tjko/ucs-millennium-falcon-led-controller/schematic.pdf

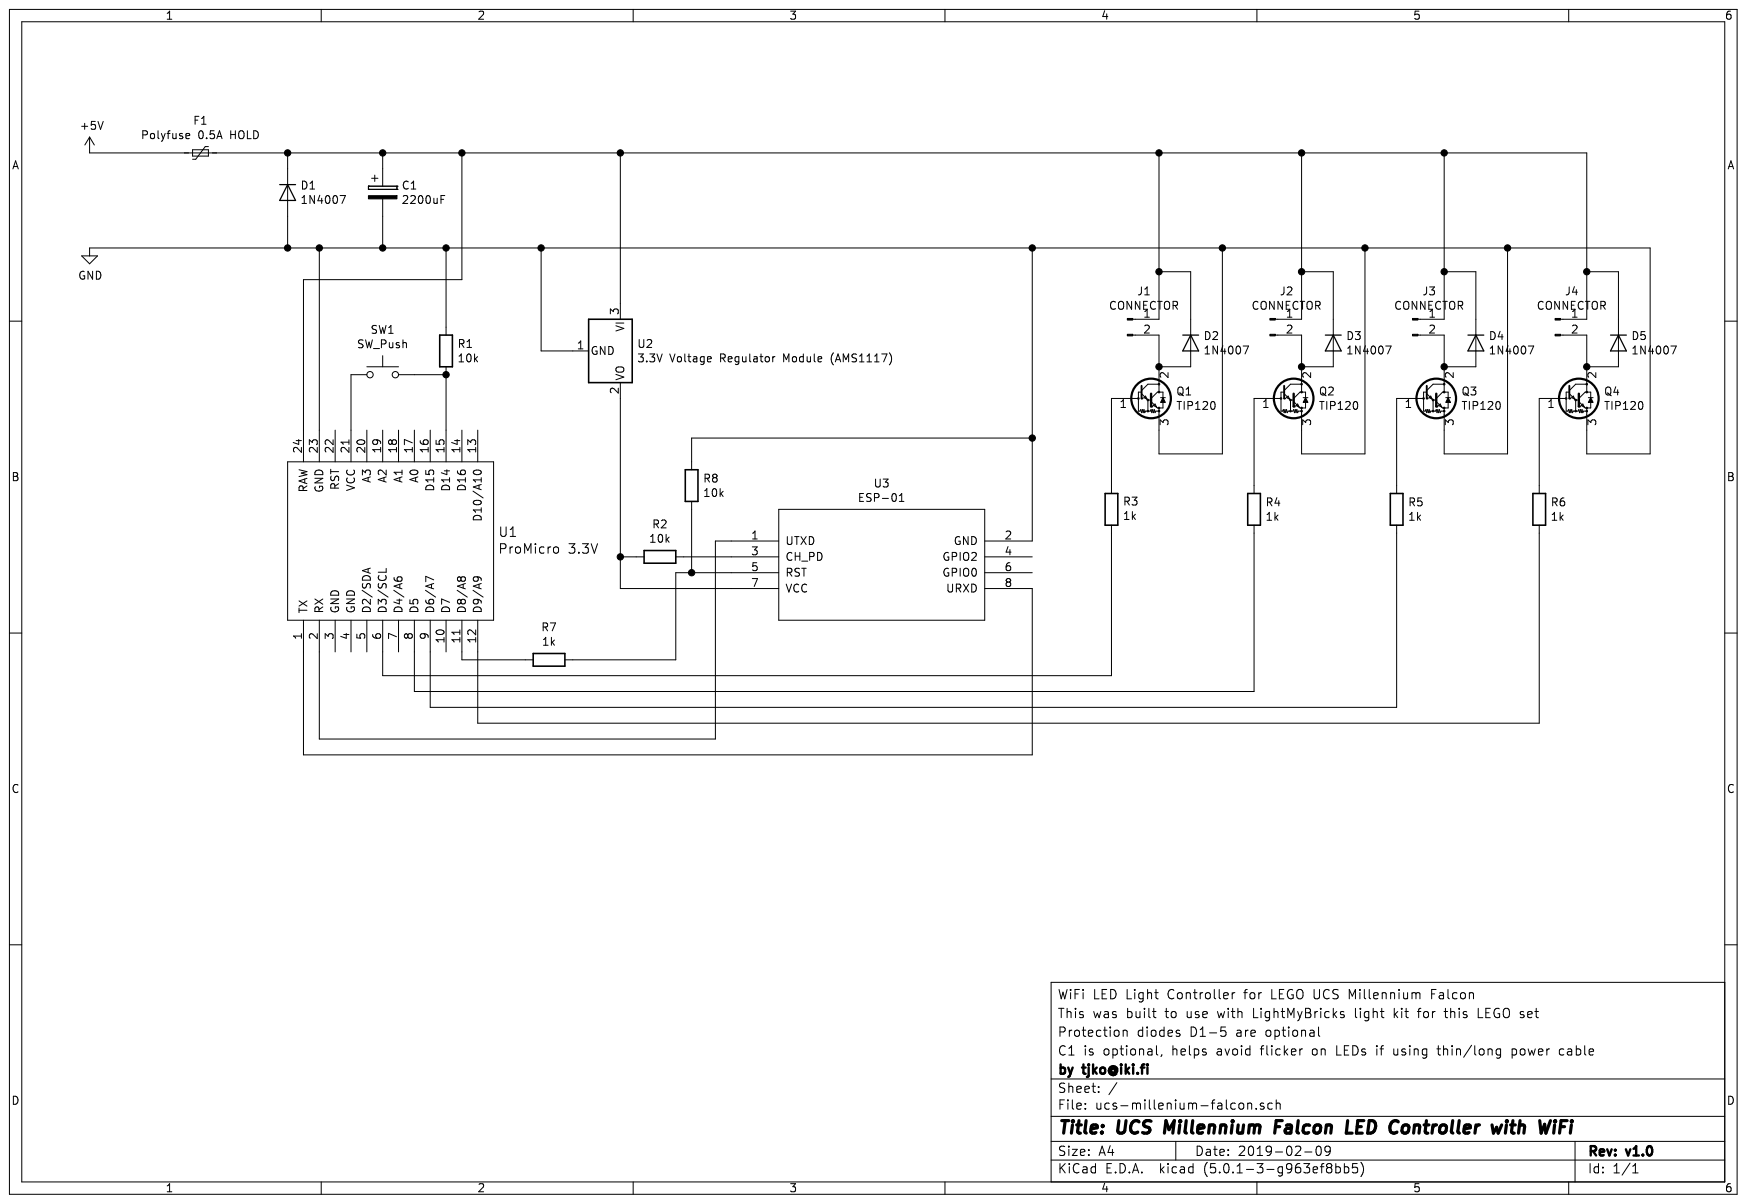
[picture p4: page 1]
